Batterhead221/brain_board/docs/ADC.png

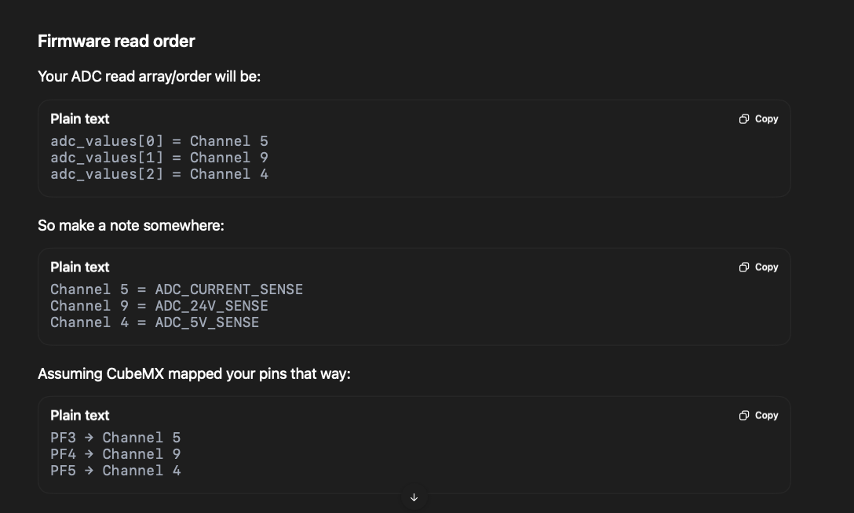
docs/ADC.png
