Batterhead221/brain_board/docs/STM32H753ZITx_LQFP144.png

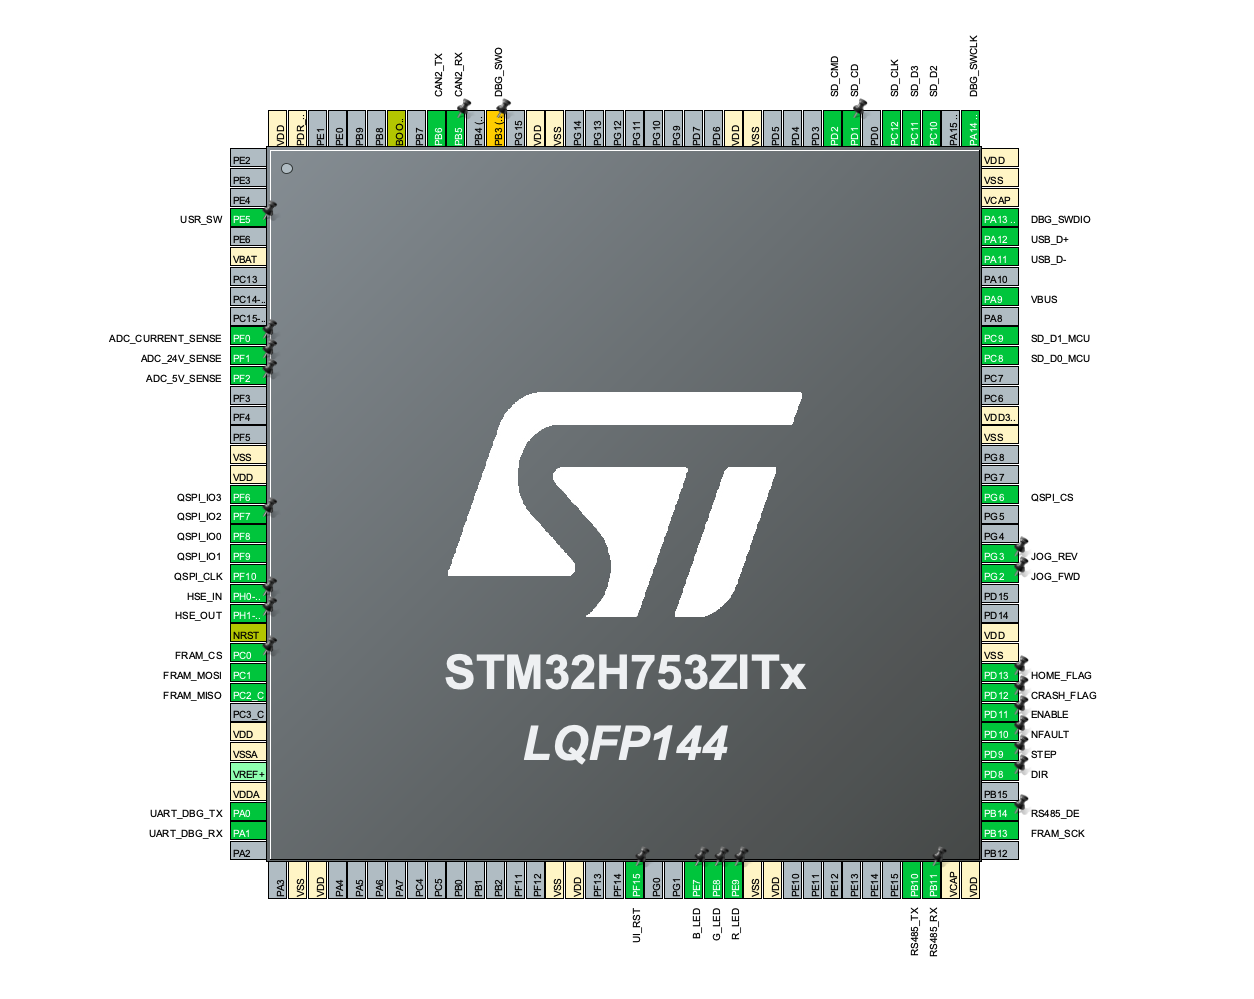
docs/STM32H753ZITx_LQFP144.png
