Batterhead221/brain_board/Outputs/IMG/L1-SIG.png

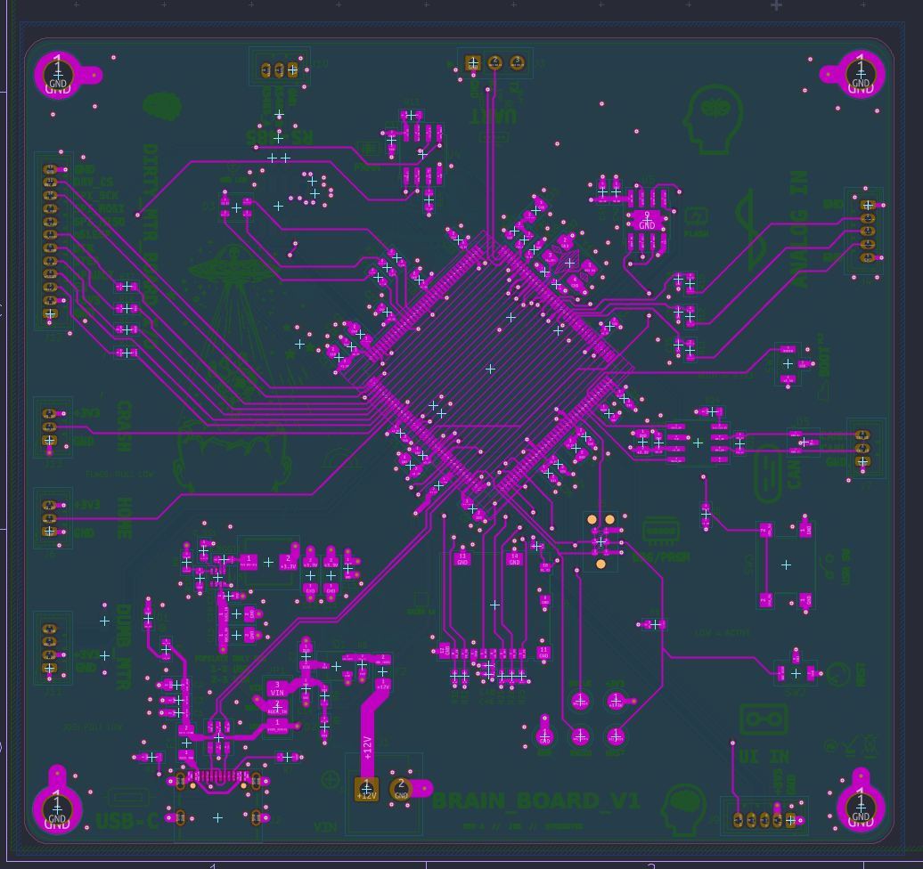
Outputs/IMG/L1-SIG.png
