Batterhead221/brain_board/Outputs/IMG/L2-3V3.png

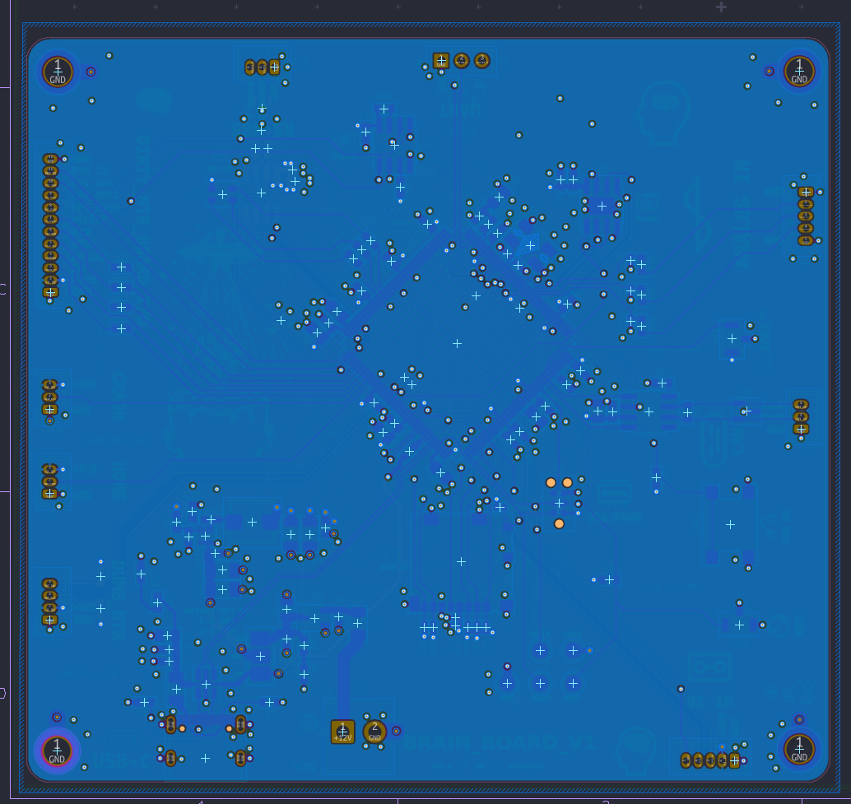
Outputs/IMG/L2-3V3.png
