Batterhead221/brain_board/Outputs/IMG/L3-GND.png

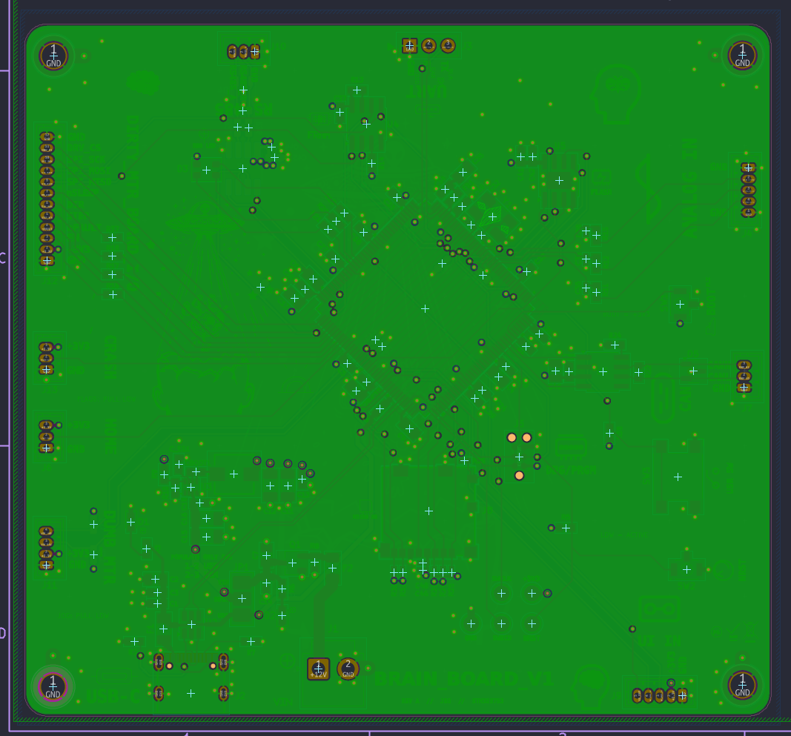
Outputs/IMG/L3-GND.png
