Batterhead221/brain_board/Outputs/IMG/L4-MIX.png

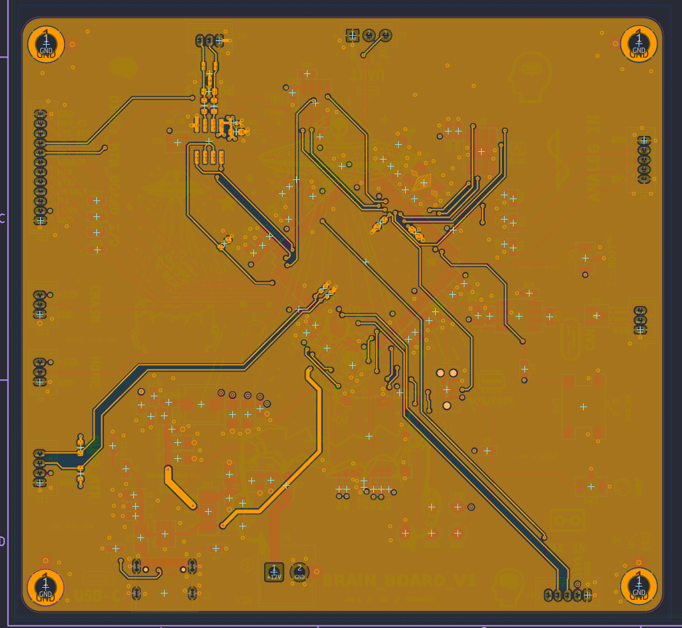
Outputs/IMG/L4-MIX.png
