Batterhead221/brain_board/Outputs/IMG/SCHEMATIC.png

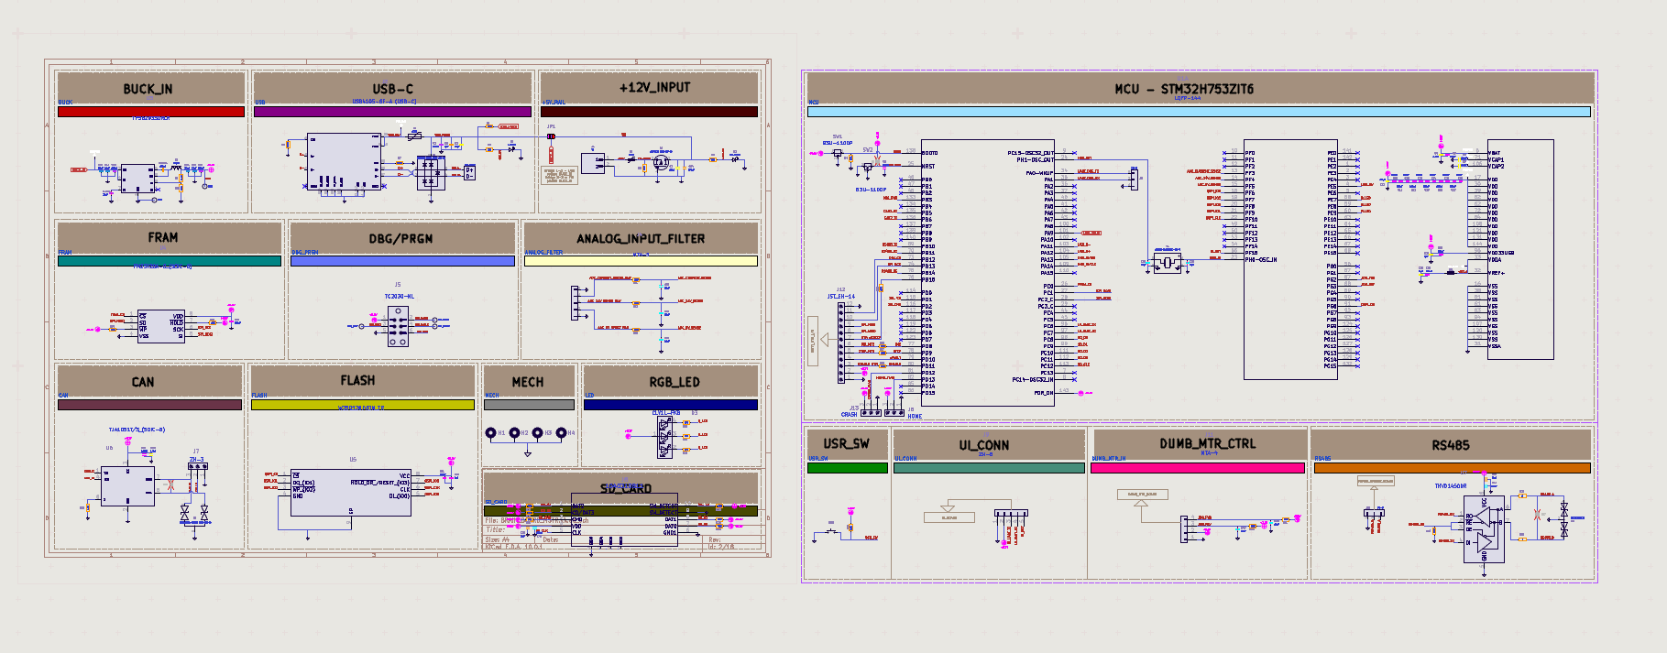
Outputs/IMG/SCHEMATIC.png
