Batterhead221/brain_board/docs/Brain_Board_Connector_Notes.ods

Sheet: Connector Summary
BRAIN_BOARD CONNECTOR REFERENCE
BRAIN_BOARD_V1 / REV A – PINOUT
REF | NAME / PURPOSE | INTERFACE TYPE | PIN COUNT | CONNECTOR TYPE | KEY NOTES
J1 | V-IN INPUT | EXTERNAL POWER INPUT | 2 | JST-VH | EXTERNAL DC INPUT. USE JP1 TO SELECT VIN PATH
J2 | USB-C | USB DATA / OPTIONAL USB POWER PATH | - | USB-C | USB_OTG_FS DEVICE MODE; PA11 D-, PA12 D+, PA9 VBUS
J3 | DEBUG UART | 3-PIN SERIAL DEBUG HEADER | 3 | DUPONT | UART4 ON PA0/PA1
J4 | ANALOG INPUT | ADC INPUT HEADER | 5 | JST-EH | ADC3 SENSE INPUTS ON PF3/PF4/PF5
J5 | DBG/PRGM | SWD PROGRAMMING/DEBUG | 6 | TAG-CONNECT | VTREF, SWDIO, GND, SWCLK, NRST, SWO
J6 | DUMB_MTR_IN | MANUAL JOG / MOTOR-CONTROL INPUT BOARD | 4 | JST-EH | ACTIVE-LOW JOG_FWD/JOG_REV; EXTERNAL BUTTONS PULL TO GND
J7 | CAN | CAN BUS CONNECTOR | 3 | JST-EH | CANH/CANL/GND VIA CAN TRANSCEIVER. 120 OHM ONLY AT BUS END
J8 | MICRO-SD | MICROSD CARD SOCKET | - | - | SDMMC1 4-BIT BUS; CMD AND D0-D3 NEED PULL-UPS
J9 | UI_IN | UI/DISPLAY DAUGHTER-BOARD CONNECTOR | 5 | JST-EH | USART6 ON PC6/PC7 PLUS UI_RST ON PF15
J10 | RS485 | RS485 BUS CONNECTOR | 3 | JST-EH | USART3 ON PB10/PB11; PB14 RS485_DE
J11 | HOME | HOME SWITCH / FLAG INPUT | 3 | JST-EH | ACTIVE-LOW HOME_FLAG ON PD13
J12 | DIRTY_MTR_BOARD I/O | MOTOR-DRIVER DAUGHTER-BOARD CONTROL | 12 | JST-EH | LOGIC/CONTROL ONLY; NO VM MOTOR POWER
J13 | CRASH | CRASH/LIMIT SWITCH INPUT | 3 | JST-EH | ACTIVE-LOW CRASH_FLAG ON PD12
JP1 | POWER SOURCE SELECT | USB/VIN SELECTION JUMPER | 3 | JUMPER | POPULATE ONLY ONE SOURCE SELECTION: 1-2 USB, 2-3 VIN

Sheet: Pinouts
Brain_Board Connector Pinout Table
All connector pins/signals in one filterable table
Connector | Connector Name | Pin | Signal | Direction | MCU Pin / Peripheral | Voltage / Level | Notes | Verify?
J1 | VIN Input | 1 | GND | Power | Board ground | 0 V | Board ground reference
J1 | VIN Input | 2 | VIN | Power input | Power path | External VIN | External DC input; use JP1 to select VIN path
J2 | USB-C | - | USB_D+ | Bidirectional | PA12 / USB_OTG_FS_DP | USB differential | USB device D+ line; ESD close to connector
J2 | USB-C | - | USB_D- | Bidirectional | PA11 / USB_OTG_FS_DM | USB differential | USB device D- line; ESD close to connector
J2 | USB-C | - | USB_VBUS | Input / power path | PA9 / VBUS sense | 5 V USB | Used for USB VBUS sensing and/or USB power path
J2 | USB-C | - | CC1/CC2 | Configuration | USB-C CC network | USB-C | Attach/orientation configuration; verify CC resistors
J2 | USB-C | - | GND | Power | Board ground | 0 V | USB ground
J3 | Debug UART | 1 | GND | Power ref | GND | 0 V | Connect to USB-UART adapter GND
J3 | Debug UART | 2 | UART_DBG_RX / MCU_RX | Input to MCU | PA1 / UART4_RX | 3.3 V logic | Connect to adapter TX
J3 | Debug UART | 3 | UART_DBG_TX / MCU_TX | Output from MCU | PA0 / UART4_TX | 3.3 V logic | Connect to adapter RX
J4 | Analog Input | 1 | GND | Power ref | GND | 0 V | Analog/reference ground | Verify final pin order
J4 | Analog Input | 2 | ADC_CURRENT_SENSE | Input | PF3 / ADC3 Channel 5 | 0-3.3 V max | Current-sense input; Rank 1 | Verify final pin order
J4 | Analog Input | 3 | ADC_24V_SENSE | Input | PF4 / ADC3 Channel 9 | 0-3.3 V max | Scaled 24 V sense input; Rank 2 | Verify final pin order
J4 | Analog Input | 4 | ADC_5V_SENSE | Input | PF5 / ADC3 Channel 4 | 0-3.3 V max | Scaled 5 V sense input; Rank 3 | Verify final pin order
J4 | Analog Input | 5 | Reserved / Analog spare | Input | TBD | 0-3.3 V max | Verify against final KiCad schematic | Yes
J4 | Analog Input | 6 | GND | Power ref | GND | 0 V | Analog/reference ground | Verify final pin order
J5 | DBG/PRGM SWD | 1 | VTREF_3V3 | Reference | 3V3 rail | 3.3 V | Target voltage reference for debugger, not main power input | Verify final pin order
J5 | DBG/PRGM SWD | 2 | SWDIO | Bidirectional | PA13 / SWDIO | 3.3 V logic | SWD data | Verify final pin order
J5 | DBG/PRGM SWD | 3 | GND | Power ref | GND | 0 V | Debug ground | Verify final pin order
J5 | DBG/PRGM SWD | 4 | SWCLK | Input | PA14 / SWCLK | 3.3 V logic | SWD clock | Verify final pin order
J5 | DBG/PRGM SWD | 5 | NRST | Bidirectional | NRST | 3.3 V logic | Target reset | Verify final pin order
J5 | DBG/PRGM SWD | 6 | SWO | Output | PB3 / SWO | 3.3 V logic | Optional trace/debug output | Verify final pin order
J6 | DUMB_MTR_IN | 1 | +3V3 | Power output | 3V3 rail | 3.3 V | Optional logic supply for external button board | Verify final pin order
J6 | DUMB_MTR_IN | 2 | JOG_FWD | Input | PG2 / GPIO input pull-up | Active-low | Button open = HIGH; pressed = LOW | Verify final pin order
J6 | DUMB_MTR_IN | 3 | JOG_REV | Input | PG3 / GPIO input pull-up | Active-low | Button open = HIGH; pressed = LOW | Verify final pin order
J6 | DUMB_MTR_IN | 4 | GND | Power ref | GND | 0 V | External switch/button ground | Verify final pin order
J7 | CAN | 1 | CANH | Bidirectional | CAN transceiver bus side | CAN bus | CAN high line | Verify final pin order
J7 | CAN | 2 | CANL | Bidirectional | CAN transceiver bus side | CAN bus | CAN low line | Verify final pin order
J7 | CAN | 3 | GND | Power ref | GND | 0 V | Bus reference ground | Verify final pin order
J8 | microSD Socket | - | SD_D0 | Bidirectional | PC8 / SDMMC1_D0 | 3.3 V logic | SDMMC1 data 0
J8 | microSD Socket | - | SD_D1 | Bidirectional | PC9 / SDMMC1_D1 | 3.3 V logic | SDMMC1 data 1
J8 | microSD Socket | - | SD_D2 | Bidirectional | PC10 / SDMMC1_D2 | 3.3 V logic | SDMMC1 data 2
J8 | microSD Socket | - | SD_D3 | Bidirectional | PC11 / SDMMC1_D3 | 3.3 V logic | SDMMC1 data 3
J8 | microSD Socket | - | SD_CLK | Output | PC12 / SDMMC1_CK | 3.3 V logic | SDMMC clock
J8 | microSD Socket | - | SD_CMD | Bidirectional | PD2 / SDMMC1_CMD | 3.3 V logic | SD command
J8 | microSD Socket | - | SD_CD | Input | PD1 / GPIO input pull-up | Active-low typical | Card detect; verify socket behavior
J8 | microSD Socket | - | +3V3 | Power | 3V3 rail | 3.3 V | microSD supply
J8 | microSD Socket | - | GND | Power | GND | 0 V | microSD ground
J9 | UI_IN | 1 | +3V3 | Power output | 3V3 rail | 3.3 V | UI logic supply | Verify final pin order
J9 | UI_IN | 2 | UI_UART_TX | Output from MCU | PC6 / USART6_TX | 3.3 V logic | MCU transmit to UI board | Verify final pin order
J9 | UI_IN | 3 | UI_UART_RX | Input to MCU | PC7 / USART6_RX | 3.3 V logic | MCU receive from UI board | Verify final pin order
J9 | UI_IN | 4 | UI_RST | Output | PF15 / GPIO output | 3.3 V logic | LOW = UI held in reset; HIGH = release | Verify final pin order
J9 | UI_IN | 5 | GND | Power ref | GND | 0 V | Ground | Verify final pin order
J10 | RS485 | 1 | RS485_A / RS485_P | Bidirectional | RS485 transceiver bus side | RS485 differential | Positive/non-inverting bus line; verify naming | Verify final pin order
J10 | RS485 | 2 | RS485_B / RS485_N | Bidirectional | RS485 transceiver bus side | RS485 differential | Negative/inverting bus line; verify naming | Verify final pin order
J10 | RS485 | 3 | GND | Power ref | GND | 0 V | Bus reference ground | Verify final pin order
J11 | HOME | 1 | +3V3 | Power output | 3V3 rail | 3.3 V | Optional powered sensor/flag supply | Verify final pin order
J11 | HOME | 2 | HOME_FLAG | Input | PD13 / EXTI pull-up | Active-low | Open = HIGH; tripped = LOW | Verify final pin order
J11 | HOME | 3 | GND | Power ref | GND | 0 V | Switch/sensor ground | Verify final pin order
J12 | DIRTY_MTR_BOARD I/O | 1 | GND | Power ref | GND | 0 V | Common ground | Verify against Dirty_MTR board
J12 | DIRTY_MTR_BOARD I/O | 2 | +3V3 | Power output | 3V3 rail | 3.3 V | Logic reference/supply only | Verify against Dirty_MTR board
J12 | DIRTY_MTR_BOARD I/O | 3 | EN / ENABLE | Output | PD11 / GPIO output | 3.3 V logic | Default LOW; driver disabled at boot | Verify against Dirty_MTR board
J12 | DIRTY_MTR_BOARD I/O | 4 | nSLEEP / MTR_nSLEEP | Output | PB15 / GPIO output | Active-low | Default LOW; driver asleep at boot | Verify against Dirty_MTR board
J12 | DIRTY_MTR_BOARD I/O | 5 | nFAULT / MTR_nFAULT | Input | PD10 / GPIO input pull-up | Active-low | LOW = driver fault | Verify against Dirty_MTR board
J12 | DIRTY_MTR_BOARD I/O | 6 | STEP | Output | PD9 / GPIO output | 3.3 V logic | Step pulse output; default LOW | Verify against Dirty_MTR board
J12 | DIRTY_MTR_BOARD I/O | 7 | DIR | Output | PD8 / GPIO output | 3.3 V logic | Direction output; default LOW | Verify against Dirty_MTR board
J12 | DIRTY_MTR_BOARD I/O | 8 | DRV_CS | Output | PB12 / GPIO output | 3.3 V logic | SPI chip-select; default HIGH | Verify against Dirty_MTR board
J12 | DIRTY_MTR_BOARD I/O | 9 | SPI_SCK | Output | PB13 / SPI2_SCK | 3.3 V logic | Shared SPI clock | Verify against Dirty_MTR board
J12 | DIRTY_MTR_BOARD I/O | 10 | SPI_MOSI | Output | PC1 / SPI2_MOSI | 3.3 V logic | MCU to driver | Verify against Dirty_MTR board
J12 | DIRTY_MTR_BOARD I/O | 11 | SPI_MISO | Input | PC2_C / SPI2_MISO | 3.3 V logic | Driver to MCU | Verify against Dirty_MTR board
J12 | DIRTY_MTR_BOARD I/O | 12 | GND | Power ref | GND | 0 V | Common ground | Verify against Dirty_MTR board
J13 | CRASH | 1 | +3V3 | Power output | 3V3 rail | 3.3 V | Optional powered sensor/flag supply | Verify final pin order
J13 | CRASH | 2 | CRASH_FLAG | Input | PD12 / EXTI pull-up | Active-low | Open = HIGH; tripped = LOW | Verify final pin order
J13 | CRASH | 3 | GND | Power ref | GND | 0 V | Switch/sensor ground | Verify final pin order
JP1 | Power Source Select | 1-2 | USB source selected | Power jumper | USB power path | USB 5 V path | Populate only one source selection | Verify final schematic
JP1 | Power Source Select | 2-3 | VIN source selected | Power jumper | VIN power path | VIN path | Populate only one source selection | Verify final schematic

Sheet: MCU Signal Map
MCU Signal Map
Firmware-facing map of signals, pins, and connector usage
Signal | MCU Pin | Peripheral / Mode | Connector(s) | Direction | Boot / Default | Notes
UART_DBG_TX | PA0 | UART4_TX | J3 | Output | 115200 8N1 | Debug boot log TX
UART_DBG_RX | PA1 | UART4_RX | J3 | Input | 115200 8N1 | Debug console RX
USB_D- | PA11 | USB_OTG_FS_DM | J2 | Bidirectional | USB Device | USB D-
USB_D+ | PA12 | USB_OTG_FS_DP | J2 | Bidirectional | USB Device | USB D+
VBUS | PA9 | USB VBUS sense | J2 | Input | VBUS sensing | USB attach/power sense
SWDIO | PA13 | SWDIO | J5 | Bidirectional | Debug | SWD data
SWCLK | PA14 | SWCLK | J5 | Input | Debug | SWD clock
SWO | PB3 | SWO | J5 | Output | Optional | Trace/debug output
CAN2_RX | PB5 | FDCAN2_RX | J7 | Input | 500 kbit/s Classic CAN | From CAN transceiver
CAN2_TX | PB6 | FDCAN2_TX | J7 | Output | 500 kbit/s Classic CAN | To CAN transceiver
RS485_TX | PB10 | USART3_TX | J10 | Output | 115200 8N1 | To RS485 transceiver DI
RS485_RX | PB11 | USART3_RX | J10 | Input | 115200 8N1 | From RS485 transceiver RO
RS485_DE | PB14 | GPIO Output | J10 | Output | LOW | LOW=receive/listen, HIGH=transmit
DRV_CS | PB12 | GPIO Output | J12 | Output | HIGH | SPI device deselected
SPI_SCK | PB13 | SPI2_SCK | J12 / FRAM | Output | 8-bit SPI, slow prescaler | Shared SPI clock
MTR_nSLEEP | PB15 | GPIO Output | J12 | Output | LOW | Driver asleep at boot
FRAM_CS | PC0 | GPIO Output | FRAM | Output | HIGH | FRAM deselected
SPI_MOSI | PC1 | SPI2_MOSI | J12 / FRAM | Output | 8-bit SPI | MCU to SPI devices
SPI_MISO | PC2_C | SPI2_MISO | J12 / FRAM | Input | 8-bit SPI | SPI devices to MCU
UI_UART_TX | PC6 | USART6_TX | J9 | Output | 115200 8N1 | UI daughter-board UART TX
UI_UART_RX | PC7 | USART6_RX | J9 | Input | 115200 8N1 | UI daughter-board UART RX
SD_D0 | PC8 | SDMMC1_D0 | J8 | Bidirectional | 4-bit SD bus | microSD data 0
SD_D1 | PC9 | SDMMC1_D1 | J8 | Bidirectional | 4-bit SD bus | microSD data 1
SD_D2 | PC10 | SDMMC1_D2 | J8 | Bidirectional | 4-bit SD bus | microSD data 2
SD_D3 | PC11 | SDMMC1_D3 | J8 | Bidirectional | 4-bit SD bus | microSD data 3
SD_CLK | PC12 | SDMMC1_CK | J8 | Output | Very high speed | microSD clock
SD_CMD | PD2 | SDMMC1_CMD | J8 | Bidirectional | 4-bit SD bus | microSD command
SD_CD | PD1 | GPIO Input pull-up | J8 | Input | Pull-up | Card detect
DIR | PD8 | GPIO Output | J12 | Output | LOW | Motor direction
STEP | PD9 | GPIO Output | J12 | Output | LOW | Motor step pulse
MTR_nFAULT | PD10 | GPIO Input pull-up | J12 | Input | HIGH normal | LOW=fault
ENABLE | PD11 | GPIO Output | J12 | Output | LOW | Motor driver disabled at boot
CRASH_FLAG | PD12 | EXTI Input pull-up | J13 | Input | HIGH normal | LOW=crash/limit active
HOME_FLAG | PD13 | EXTI Input pull-up | J11 | Input | HIGH normal | LOW=home active
USR_SW | PE5 | GPIO Input pull-up | SW3 | Input | HIGH normal | LOW=pressed
B_LED | PE7 | GPIO Output | LED | Output | LOW | Blue LED control
G_LED | PE8 | GPIO Output | LED | Output | LOW | Green heartbeat LED
R_LED | PE9 | GPIO Output | LED | Output | LOW | Red LED control
ADC_CURRENT_SENSE | PF3 | ADC3 Channel 5 | J4 | Input | Rank 1 | 0-3.3 V max
ADC_24V_SENSE | PF4 | ADC3 Channel 9 | J4 | Input | Rank 2 | 0-3.3 V max
ADC_5V_SENSE | PF5 | ADC3 Channel 4 | J4 | Input | Rank 3 | 0-3.3 V max
QSPI_IO3 | PF6 | QUADSPI IO3 | Flash | Bidirectional | QSPI | External flash IO3
QSPI_IO2 | PF7 | QUADSPI IO2 | Flash | Bidirectional | QSPI | External flash IO2
QSPI_IO0 | PF8 | QUADSPI IO0 | Flash | Bidirectional | QSPI | External flash IO0
QSPI_IO1 | PF9 | QUADSPI IO1 | Flash | Bidirectional | QSPI | External flash IO1
QSPI_CLK | PF10 | QUADSPI CLK | Flash | Output | QSPI | External flash clock
UI_RST | PF15 | GPIO Output | J9 | Output | LOW | LOW=UI held reset
JOG_FWD | PG2 | GPIO Input pull-up | J6 | Input | HIGH normal | LOW=jog forward pressed
JOG_REV | PG3 | GPIO Input pull-up | J6 | Input | HIGH normal | LOW=jog reverse pressed
QSPI_CS | PG6 | GPIO / QSPI CS | Flash | Output | TBD | External flash chip select
HSE_IN | PH0 | RCC HSE_IN | Y1 | Input | 25 MHz HSE | Crystal input
HSE_OUT | PH1 | RCC HSE_OUT | Y1 | Output | 25 MHz HSE | Crystal output

Sheet: Active-Low Signals
Active-Low / Boot-Safe Signals
Signals that need special attention during firmware bring-up
Signal | Connector / Location | MCU Pin | Active State | Inactive State | Pull / Default | Firmware Note
MTR_nSLEEP | J12 | PB15 | LOW = sleep | HIGH = awake | Output LOW at boot | Do not wake driver until motor board is tested
MTR_nFAULT | J12 | PD10 | LOW = fault | HIGH = normal | Input pull-up | Poll or later use EXTI/fault handling
HOME_FLAG | J11 | PD13 | LOW = active | HIGH = inactive | EXTI input pull-up | Mechanical switch pulls to GND
CRASH_FLAG | J13 | PD12 | LOW = active | HIGH = inactive | EXTI input pull-up | Treat as safety-critical
JOG_FWD | J6 | PG2 | LOW = pressed | HIGH = open | Input pull-up | External button pulls to GND
JOG_REV | J6 | PG3 | LOW = pressed | HIGH = open | Input pull-up | External button pulls to GND
USR_SW | SW3 | PE5 | LOW = pressed | HIGH = open | Input pull-up | On-board user switch
RS485_DE | J10 / transceiver | PB14 | HIGH = transmit | LOW = receive | Output LOW at boot | Not active-low, but keep LOW at boot for listen mode

Sheet: Bring-Up Checklist
Brain_Board Bring-Up Checklist
Recommended first-test order after boards arrive
Order | Stage | Check / Action | Expected Result | Connector / Area | Done
1 | Power-off inspection | Inspect PCB for solder bridges, wrong footprints, and backwards polarized parts | No visible shorts or orientation errors | Full board
2 | Resistance checks | Measure +3V3 to GND, VIN to GND, USB_VBUS to GND | No dead short | Power rails
3 | Power source select | Verify JP1 source selection | Only one source path selected | JP1
4 | First power | Power from current-limited supply if possible | Current draw sane, no hot parts | J1/J2/JP1
5 | Rail check | Measure +3V3 rail | 3.3 V nominal | 3V3 test point / rail
6 | Reset/boot | Verify NRST high and BOOT0 low | Normal boot state | J5 / SW1
7 | SWD attach | Connect ST-Link to DBG/PRGM | Debugger detects STM32H753 | J5
8 | Flash firmware | Flash heartbeat firmware | Programming succeeds | J5
9 | LED heartbeat | Observe G_LED blink | Blink every ~500 ms | G_LED
10 | Debug UART | Connect USB-UART and read boot message | Brain_Board boot | J3
11 | Safe motor state | Check MTR_nSLEEP, ENABLE, STEP, DIR, DRV_CS | nSLEEP LOW, ENABLE LOW, STEP LOW, DIR LOW, CS HIGH | J12
12 | ADC readback | Read ADC3 channels | Reasonable scaled values | J4
13 | SPI FRAM | Test FRAM over SPI2 | JEDEC/read-write test passes if supported | FRAM / SPI2
14 | microSD | Test card detect and SDMMC mount | Card detect works, filesystem mounts | J8
15 | USB device | Plug USB-C to host | USB enumerates | J2
16 | RS485 | Test TX/RX with DE control | Receive mode default, transmit works when DE high | J10
17 | CAN | Test CAN with second node or analyzer | 500 kbit/s Classic CAN frames pass | J7
18 | Daughter board link | Connect Dirty_MTR_Board with motor power OFF first | Logic/control signals match pinout | J12
19 | Motor test last | Enable motor driver and step slowly | Motor moves only after all logic tests pass | Dirty_MTR_Board
