Batterhead221/brain_board/ECAD/BRAIN_BOARD.kicad_pcb

## KiCad design ECAD/BRAIN_BOARD.kicad_pcb (2026-05-13)

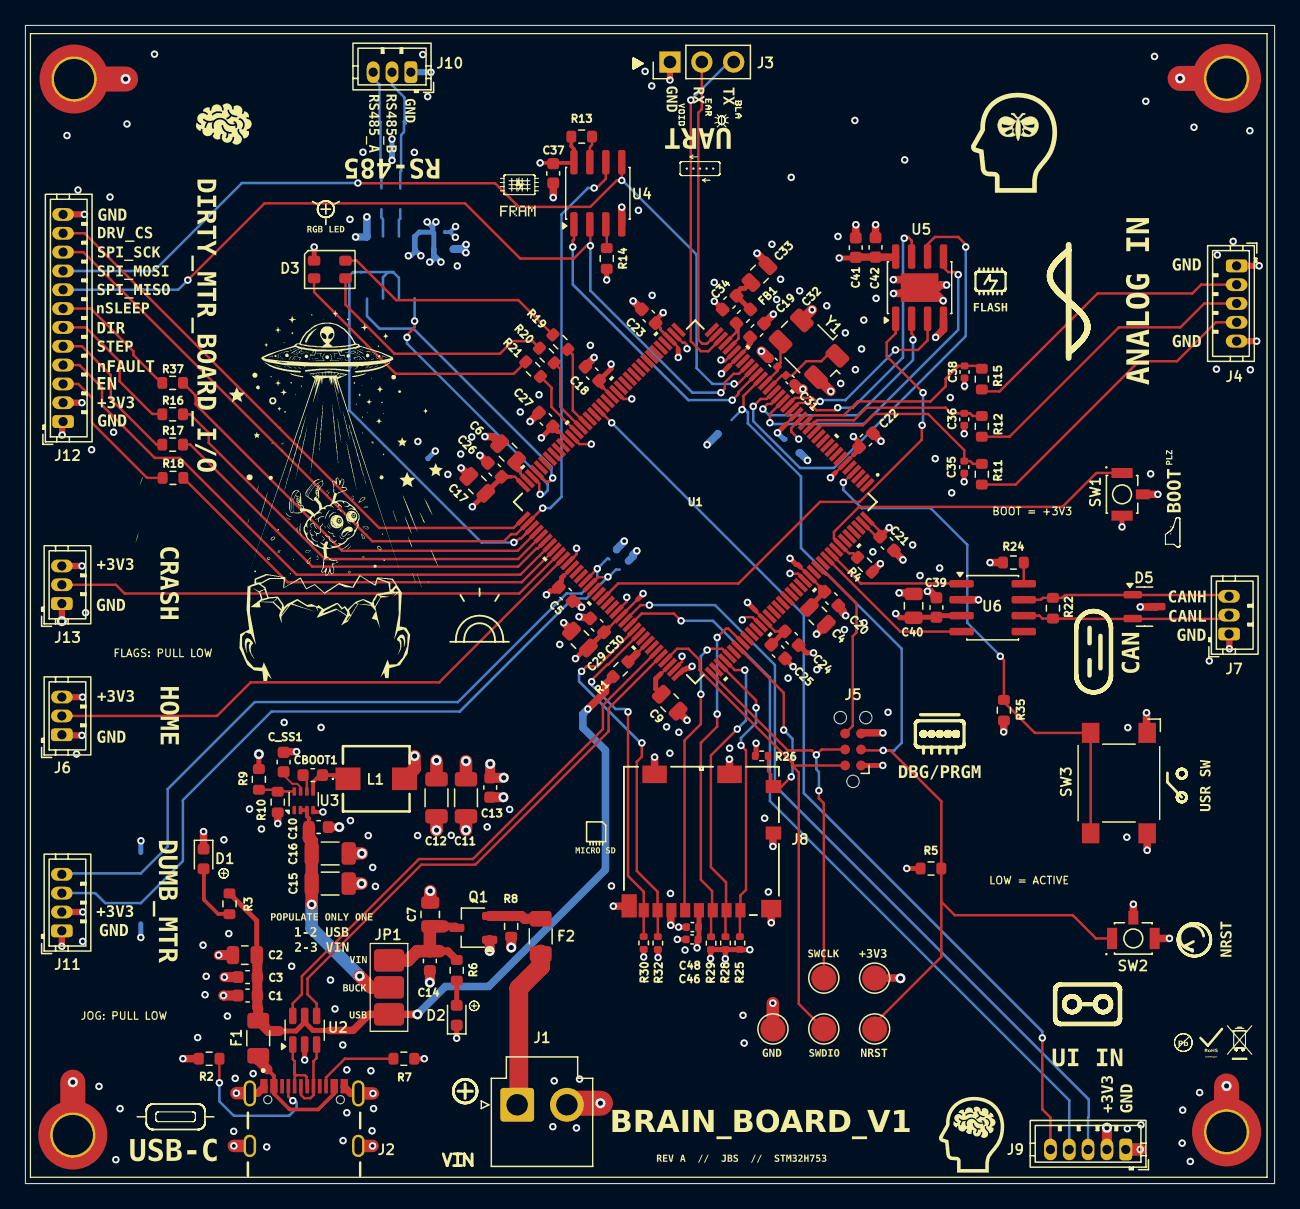
[picture p10: board BRAIN_BOARD.kicad_pcb from above]

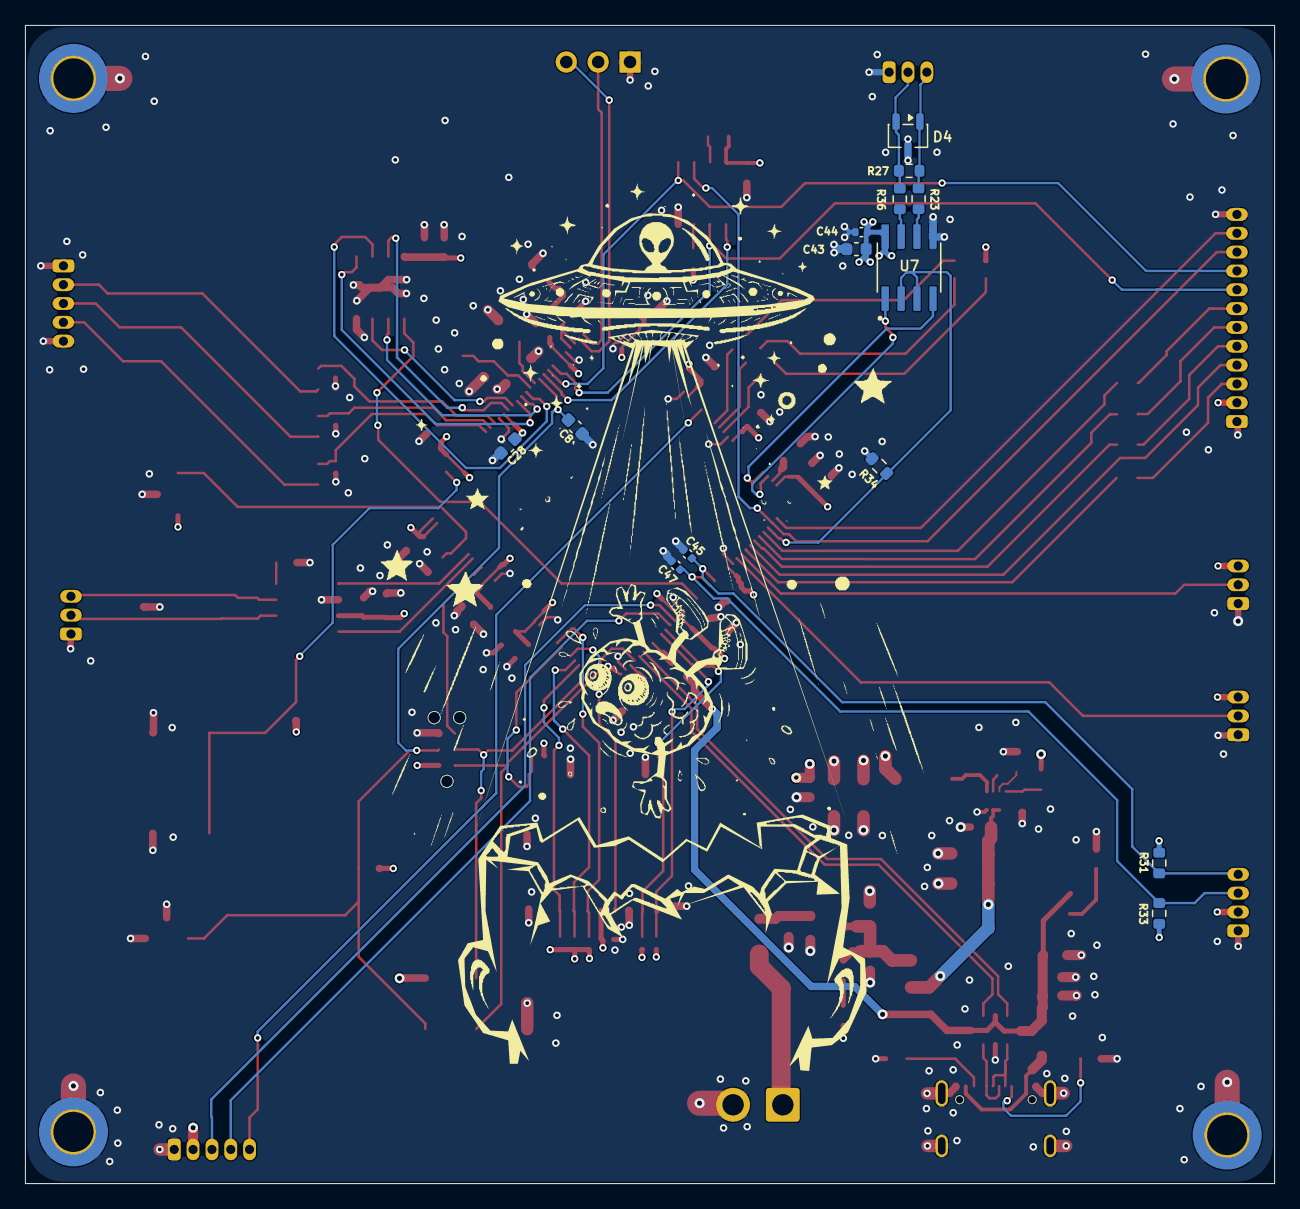
[picture p11: board BRAIN_BOARD.kicad_pcb from below]

Board: 4 copper layers, 99.5 x 92.2 mm, 131 parts (14 on the bottom side), 95 nets.

Parts:
C1, C5, C8, C10, C13, C14, C18, C19, C20, C21, C22, C23, C24, C25, C26, C27, C28, C30, C34, C37, C41: 100nF; C_0603_1608Metric
C2, C7: 10µF; C_0805_2012Metric
C3, C42: 1µF; C_0603_1608Metric
C4, C6, C9: 2.2µF; C_0805_2012Metric
C11, C12: 22µF; C_1206_3216Metric
C15, C16: 10µF; C_1206_3216Metric
C17, C40: 4.7µF; C_0805_2012Metric
C29, C33: 1µF; C_0805_2012Metric
C31, C32: 18pF; C_0402_1005Metric
C35, C36, C38, C45, C47: 10nF; C_0402_1005Metric
C39: 100NF; C_0603_1608Metric
C43: 10µF; C_0603_1608Metric
C44, C46: 100nF; C_0402_1005Metric
C48: 1µF; C_0402_1005Metric
CBOOT1: 100nF; C_0603_1608Metric
C_SS1: 33nF; C_0603_1608Metric
D1: +5V_SIG; LED_0603_1608Metric
D2: LED_GREEN; LED_0603_1608Metric
D3: CLV1L-FKB; LED_Cree-PLCC4_3.2x2.8mm_CCW
D4: SM712_SOT23; SOT-23-3
D5: SM24CANB-02HTG (SOT-23-3); SOT-23
F1, F2: 1206; Fuse_1206_3216Metric
FB1: FERRITE_BEAD; Fuse_0603_1608Metric
H1, H2, H3, H4: MountingHole_Pad; MountingHole_3.2mm_M3_ISO14580_Pad_TopBottom
J1: VH; JST_VH_B2P-VH_1x02_P3.96mm_Vertical
J2: USB4105-GF-A (USB-C); GCT_USB4105-GF-A
J3: ZH-3; PinHeader_1x03_P2.54mm_Vertical
J4: MTA-5; JST_ZH_B5B-ZR_1x05_P1.50mm_Vertical
J5: TC2030-NL; Tag-Connect_TC2030-IDC-NL_2x03_P1.27mm_Vertical
J6: HOME; JST_ZH_B3B-ZR_1x03_P1.50mm_Vertical
J7: ZH-3; JST_ZH_B3B-ZR_1x03_P1.50mm_Vertical
J8: 1040310811; 104031-0811_MOL
J9: ZH-5; JST_ZH_B5B-ZR_1x05_P1.50mm_Vertical
J10: PH-3; JST_ZH_B3B-ZR_1x03_P1.50mm_Vertical
J11: MTA-4; JST_ZH_B4B-ZR_1x04_P1.50mm_Vertical
J12: JST_EH-14; JST_ZH_B12B-ZR_1x12_P1.50mm_Vertical
J13: CRASH; JST_ZH_B3B-ZR_1x03_P1.50mm_Vertical
JP1: BEEFY_JUMPER; PWR_JMP_BEEFY
L1: 4.7µH; L_SRP5030TA4R7M
Q1: AO3407A (SOT-23-3); TSOT-23
R1, R5, R8, R10, R13, R14, R31, R33, R34, R35: 10K; R_0603
R2, R7: 5.1K; R_0603
R3, R6: 750; R_0603
R4: 5K1; R_0603
R9: 31.6K; R_0603
R11, R12, R15, R16, R17, R18, R37: 100; R_0603
R19, R20, R21: 470; R_0603
R22, R27: 120; R_0603
R23, R36: 0; R_0603
R24: 4.7K; R_0603
R25, R28, R29, R30, R32: 47K; R_0402_1005Metric
R26: 10K; R_0402_1005Metric
SW1, SW2: B3U-1100P; SW_B3U-1100P
SW3: SW_SPST_Omron_B3FS-100xP
TP1: 3.3V; TestPoint_Pad_D2.0mm
TP2: GND; TestPoint_Pad_D2.0mm
TP3: DBG_SWDIO; TestPoint_Pad_D2.0mm
TP4: DBG_NRST; TestPoint_Pad_D2.0mm
TP5: DBG_SWCLK; TestPoint_Pad_D2.0mm
U1: LQFP-144; LQFP144-20x20mm
U2: USBLC6-2SC6_(SOT-23-6); SOT-23-6
U3: TPS62933DRLR; SOT-583-8
U4: FM25V20A-G_(SOIC-8); SOIC-8_3.9x4.9mm_P1.27mm
U5: W25Q128JVEIM_TR; SOIC-8-1EP_3.9x4.9mm_P1.27mm_EP2.29x3mm
U6: TJA1051T/3_(SOIC-8); SOIC-8_3.9x4.9mm_P1.27mm
U7: THVD1450DR; SOIC127P599X175-8N
Y1: ABM3B-8.000MHZ-B2-T; Crystal_SMD_Abracon_ABM3B-4Pin_5.0x3.2mm

Connections:
+3.3V: C4.1, C5.1, C11.2, C12.2, C13.1, C17.1, C18.1, C19.1, C20.1, C21.1, C22.1, C23.1, C24.1, C25.1, C26.1, C27.1, C28.1, C29.2, C30.2, C37.2, C39.2, C40.2, C41.2, C42.2, C43.1, C44.2, C46.1, C48.2, D3.1 (A), J5.1 (+3V3), J6.3, J8.4 (VDD), J9.2, J11.2, J12.2, J13.3, L1.2, R5.1, R9.2, R13.1, R14.2, R25.2, R26.1, R28.2, R29.2, R30.1, R31.1, R32.1, R33.1, R35.2, SW1.2, TP1.1, U1.6 (VBAT), U1.17 (VDD), U1.30 (VDD), U1.39 (VDD), U1.52 (VDD), U1.62 (VDD), U1.72 (VDD), U1.84 (VDD), U1.95 (VDD33USB), U1.108 (VDD), U1.121 (VDD), U1.131 (VDD), U1.143 (PDR_ON), U1.144 (VDD), U4.8 (VDD), U5.8 (VCC), U6.3 (VCC), U7.8 (VCC)
/BRAIN_BOARD/+3V3_A: FB1.2, U1.32 (VREF+), U1.33 (VDDA)
/BRAIN_BOARD/+5V_SIG: D1.2 (A), R3.2
/BRAIN_BOARD/+12V: F2.1, J1.1
/BRAIN_BOARD/+12V_SIG: D2.2 (A), R6.2
/BRAIN_BOARD/ADC_5V_SENSE: C38.1, R15.1, U1.15 (PF5)
/BRAIN_BOARD/ADC_5V_SENSE_RAW: J4.2, R15.2
/BRAIN_BOARD/ADC_24V_SENSE: C36.1, R12.1, U1.14 (PF4)
/BRAIN_BOARD/ADC_24V_SENSE_RAW: J4.3, R12.2
/BRAIN_BOARD/ADC_CURRENT_SENSE: C35.1, R11.1, U1.13 (PF3)
/BRAIN_BOARD/ADC_CURRENT_SENSE_RAW: J4.4, R11.2
/BRAIN_BOARD/BOOT0: R4.1, SW1.1, U1.138 (BOOT0)
/BRAIN_BOARD/B_LED: R19.1, U1.58 (PE7)
/BRAIN_BOARD/CAN2_RX: U1.135 (PB5), U6.4 (RXD)
/BRAIN_BOARD/CAN2_TX: U1.136 (PB6), U6.1 (TXD)
/BRAIN_BOARD/CAN_HI: D5.1 (PIN_1), J7.3, R22.1, U6.7 (CANH)
/BRAIN_BOARD/CAN_LO: D5.2 (PIN_2), J7.2, R22.2, U6.6 (CANL)
/BRAIN_BOARD/CRASH_FLAG: J13.2, U1.81 (PD12)
/BRAIN_BOARD/D+: J2.A6 (D+), J2.B6 (D+), U2.3 (L2)
/BRAIN_BOARD/D-: J2.A7 (D-), J2.B7 (D-), U2.1 (L1)
/BRAIN_BOARD/DBG_NRST: C8.2, J5.3 (NRST), R5.2, SW2.1, TP4.1, U1.25 (NRST)
/BRAIN_BOARD/DBG_SWCLK: J5.4 (SWCLK), TP5.1, U1.109 (PA14)
/BRAIN_BOARD/DBG_SWDIO: J5.2 (SWDIO), TP3.1, U1.105 (PA13)
/BRAIN_BOARD/DBG_SWO: J5.6 (SWO), U1.133 (PB3)
/BRAIN_BOARD/DIR: R16.1, U1.77 (PD8)
/BRAIN_BOARD/DIR_MTR: J12.6, R16.2
/BRAIN_BOARD/DRV_CS: J12.11, U1.73 (PB12)
/BRAIN_BOARD/ENABLE: R18.1, U1.80 (PD11)
/BRAIN_BOARD/ENABLE_MTR: J12.3, R18.2
/BRAIN_BOARD/FRAM_CS: U1.26 (PC0), U4.1 (~CS)
/BRAIN_BOARD/G_LED: R20.1, U1.59 (PE8)
/BRAIN_BOARD/HOME_FLAG: J6.2, U1.82 (PD13)
/BRAIN_BOARD/HSE_IN: C31.1, U1.23 (PH0-OSC_IN), Y1.1
/BRAIN_BOARD/HSE_OUT: C32.2, U1.24 (PH1-OSC_OUT), Y1.3
/BRAIN_BOARD/JOG_FWD: C45.1, J11.4, R31.2, U1.87 (PG2)
/BRAIN_BOARD/JOG_REV: C47.1, J11.3, R33.2, U1.88 (PG3)
/BRAIN_BOARD/MTR_nSLEEP: J12.7, R37.2
/BRAIN_BOARD/QSPI_CLK: U1.22 (PF10), U5.6 (CLK)
/BRAIN_BOARD/QSPI_CS: U1.91 (PG6), U5.1 (~CS)
/BRAIN_BOARD/QSPI_IO0: U1.20 (PF8), U5.5 (DI_(IO0))
/BRAIN_BOARD/QSPI_IO1: U1.21 (PF9), U5.2 (DO_(IO1))
/BRAIN_BOARD/QSPI_IO2: U1.19 (PF7), U5.3 (~WP_(IO2))
/BRAIN_BOARD/QSPI_IO3: U1.18 (PF6), U5.7 (~HOLD_OR_/RESET_(IO3))
/BRAIN_BOARD/RS485_A: D4.1 (A1), J10.3, R23.2, R27.1
/BRAIN_BOARD/RS485_B: D4.2 (A2), J10.2, R27.2, R36.2
/BRAIN_BOARD/RS485_DE: R34.1, U1.75 (PB14), U7.2 (~RE), U7.3 (DE)
/BRAIN_BOARD/RS485_RX: U1.70 (PB11), U7.1 (RO)
/BRAIN_BOARD/RS485_TX: U1.69 (PB10), U7.4 (DI)
/BRAIN_BOARD/R_LED: R21.1, U1.60 (PE9)
/BRAIN_BOARD/SD_ CD: J8.10 (SW_DETECT), R26.2, U1.115 (PD1)
/BRAIN_BOARD/SD_CLK: J8.5 (CLK), U1.113 (PC12)
/BRAIN_BOARD/SD_CMD: J8.3 (CMD), R29.1, U1.116 (PD2)
/BRAIN_BOARD/SD_D0: J8.7 (DAT0), R32.2, U1.98 (PC8)
/BRAIN_BOARD/SD_D1: J8.8 (DAT1), R30.2, U1.99 (PC9)
/BRAIN_BOARD/SD_D2: J8.1 (DAT2), R25.1, U1.111 (PC10)
/BRAIN_BOARD/SD_D3: J8.2 (CD/DAT3), R28.1, U1.112 (PC11)
/BRAIN_BOARD/SPI_MISO: J12.8, U1.28 (PC2_C), U4.2 (SO)
/BRAIN_BOARD/SPI_MOSI: J12.9, U1.27 (PC1), U4.5 (SI)
/BRAIN_BOARD/SPI_SCK: J12.10, U1.74 (PB13), U4.6 (SCK)
/BRAIN_BOARD/STEP: R17.1, U1.78 (PD9)
/BRAIN_BOARD/STEP_MTR: J12.5, R17.2
/BRAIN_BOARD/UART_DBG_RX: J3.2, U1.35 (PA1)
/BRAIN_BOARD/UART_DBG_TX: J3.3, U1.34 (PA0-WKUP)
/BRAIN_BOARD/UI_RST: J9.5, U1.55 (PF15)
/BRAIN_BOARD/UI_UART_RX: J9.4, U1.97 (PC7)
/BRAIN_BOARD/UI_UART_TX: J9.3, U1.96 (PC6)
/BRAIN_BOARD/USB_D+: U1.104 (PA12), U2.4 (L2)
/BRAIN_BOARD/USB_D-: U1.103 (PA11), U2.6 (L1)
/BRAIN_BOARD/USR_SW: R35.1, SW3.2, U1.4 (PE5)
/BRAIN_BOARD/VBUS_FUSED: C1.1, C2.2, C3.2, F1.2, JP1.1 (A), R1.2, R3.1, U2.5 (VP)
/BRAIN_BOARD/VBUS_RAW: F1.1, J2.A4_B9 (VBUS), J2.B4_A9 (VBUS)
/BRAIN_BOARD/VIN: C7.2, C14.2, JP1.3 (B), Q1.3 (D), R6.1
/BRAIN_BOARD/VIN_FUSED: F2.2, Q1.2 (S), R8.2
/BRAIN_BOARD/nFAULT: J12.4, U1.79 (PD10)
BUCK_IN: C10.1, C15.1, C16.1, JP1.2 (C), U3.2 (EN), U3.3 (VIN)
GND: C1.2, C2.1, C3.1, C4.2, C5.2, C6.2, C7.1, C8.1, C9.2, C10.2, C11.1, C12.1, C13.2, C14.1, C15.2, C16.2, C17.2, C18.2, C19.2, C20.2, C21.2, C22.2, C23.2, C24.2, C25.2, C26.2, C27.2, C28.2, C29.1, C30.1, C31.2, C32.1, C33.1, C34.1, C35.2, C36.2, C37.1, C38.2, C39.1, C40.1, C41.1, C42.1, C43.2, C44.1, C45.2, C46.2, C47.2, C48.1, C_SS1.1, D1.1 (K), D2.1 (K), D4.3 (common), D5.3 (PIN_3), H1.1 (1_1), H2.1 (1_1), H3.1 (1_1), H4.1 (1_1), J1.2, J2.A1_B12 (GND), J2.B1_A12 (GND), J2.SH1 (SH_GND), J2.SH2 (SH_GND1), J2.SH3 (SH_GND2), J2.SH4 (SH_GND3), J3.1, J4.1, J4.5, J5.5 (GND), J6.1, J7.1, J8.6 (GND1), J8.9 (SW_DETECT), J8.11 (GND5), J8.12 (GND4), J8.13 (GND3), J8.14 (GND2), J9.1, J10.1, J11.1, J12.1, J12.12, J13.1, Q1.1 (G), R2.1, R4.2, R7.2, R8.1, R10.1, R24.2, R34.2, SW1.3, SW2.2, SW2.3, SW3.1, TP2.1, U1.16 (VSS), U1.31 (VSSA), U1.38 (VSS), U1.51 (VSS), U1.61 (VSS), U1.83 (VSS), U1.94 (VSS), U1.107 (VSS), U1.120 (VSS), U1.130 (VSS), U2.2 (VN), U3.4 (GND), U4.4 (VSS), U5.4 (GND), U5.9 (EP), U6.2 (GND), U7.5 (GND), Y1.2, Y1.4
unnamed: C33.2, C34.2, FB1.1
unnamed: D3.4 (BK), R19.2
unnamed: D3.3 (GK), R20.2
unnamed: D3.2 (RK), R21.2
unnamed: J2.A5 (CC1), R2.2
unnamed: J2.B5 (CC2), R7.1
unnamed: R37.1, U1.76 (PB15)
unnamed: C6.1, U1.71 (VCAP1)
unnamed: C9.1, U1.106 (VCAP2)
unnamed: CBOOT1.1, U3.6 (BST)
unnamed: R9.1, R10.2, U3.8 (FB)
unnamed: C_SS1.2, U3.7 (SS)
unnamed: CBOOT1.2, L1.1, U3.5 (SW)
unnamed: R13.2, U4.7 (~HOLD)
unnamed: R14.1, U4.3 (~WP)
unnamed: R24.1, U6.8 (S)
unnamed: R23.1, U7.6 (A)
unnamed: R36.1, U7.7 (B)
USB_VBUS: R1.1, U1.101 (PA9)
