Batterhead221/brain_board/firmware/STM32H753ZIT6/STM32H753ZIT6.ioc

Mcu.UserName=STM32H753ZITx
PA0.Signal=UART4_TX
PA1.Signal=UART4_RX
PA11.GPIO_Label=USB_D-
PA11.Signal=USB_OTG_FS_DM
PA12.GPIO_Label=USB_D+
PA12.Signal=USB_OTG_FS_DP
PA9.GPIO_Label=VBUS
PA9.Signal=USB_OTG_FS_VBUS
PB10.GPIO_Label=USART3_TX (485)
PB10.Signal=USART3_TX
PB11.GPIO_Label=USART3_RX (485)
PB11.Signal=USART3_RX
PB12.GPIO_Label=DRV_CS
PB12.Signal=GPIO_Output
PB14.GPIO_Label=RS485_DE
PB14.Signal=GPIO_Output
PB15.GPIO_Label=MTR_nSLEEP
PB15.Signal=GPIO_Output
PB5.GPIO_Label=CAN2_RX
PB5.Signal=FDCAN2_RX
PB6.GPIO_Label=CAN2_TX
PB6.Signal=FDCAN2_TX
PC0.GPIO_Label=FRAM_CS
PC0.Signal=GPIO_Output
PC1.GPIO_Label=FRAM_MOSI
PC1.Signal=SPI2_MOSI
PC10.GPIO_Label=SD_D2
PC10.Signal=SDMMC1_D2
PC11.GPIO_Label=SD_D3
PC11.Signal=SDMMC1_D3
PC12.GPIO_Label=SD_CLK
PC12.Signal=SDMMC1_CK
PC2_C.GPIO_Label=FRAM_MISO
PC2_C.Signal=SPI2_MISO
PC6.GPIO_Label=USART6_TX (UI)
PC6.Signal=USART6_TX
PC7.GPIO_Label=USART6_RX (UI)
PC7.Signal=USART6_RX
PC8.GPIO_Label=SD_D0_MCU
PC8.Signal=SDMMC1_D0
PC9.GPIO_Label=SD_D1_MCU
PC9.Signal=SDMMC1_D1
PD1.GPIO_Label=SD_CD
PD1.Signal=GPIO_Input
PD10.GPIO_Label=nFAULT
PD10.Signal=GPIO_Input
PD11.GPIO_Label=ENABLE
PD11.Signal=GPIO_Output
PD12.GPIO_Label=CRASH_FLAG
PD12.Signal=GPXTI12
PD13.GPIO_Label=HOME_FLAG
PD13.Signal=GPXTI13
PD2.GPIO_Label=SD_CMD
PD2.Signal=SDMMC1_CMD
PD3.GPIO_Label=SPI_SCK
PD3.Signal=SPI2_SCK
PD8.GPIO_Label=DIR
PD8.Signal=GPIO_Output
PD9.GPIO_Label=STEP
PD9.Signal=GPIO_Output
PE5.GPIO_Label=USR_SW
PE5.Signal=GPIO_Input
PE7.GPIO_Label=B_LED
PE7.Signal=GPIO_Output
PE8.GPIO_Label=G_LED
PE8.Signal=GPIO_Output
PE9.GPIO_Label=R_LED
PE9.Signal=GPIO_Output
PF10.GPIO_Label=QSPI_CLK
PF10.Signal=QUADSPI_CLK
PF15.GPIO_Label=UI_RST
PF15.Signal=GPIO_Output
PF3.GPIO_Label=ADC_CURRENT_SENSE
PF3.Signal=ADC3_INP5
PF4.GPIO_Label=ADC_24V_SENSE
PF4.Signal=ADC3_INP9
PF5.GPIO_Label=ADC_5V_SENSE
PF5.Signal=ADC3_INP4
PF6.GPIO_Label=QSPI_IO3
PF6.Signal=QUADSPI_BK1_IO3
PF7.GPIO_Label=QSPI_IO2
PF7.Signal=QUADSPI_BK1_IO2
PF8.GPIO_Label=QSPI_IO0
PF8.Signal=QUADSPI_BK1_IO0
PF9.GPIO_Label=QSPI_IO1
PF9.Signal=QUADSPI_BK1_IO1
PG2.GPIO_Label=JOG_FWD
PG2.Signal=GPIO_Input
PG3.GPIO_Label=JOG_REV
PG3.Signal=GPIO_Input
PG6.GPIO_Label=QSPI_CS
PG6.Signal=QUADSPI_BK1_NCS
