Batterhead221/brain_board/(commit log)

2026-05-03 Add initial STM32 firmware project and gitignore
    [BRAIN_BOARD.kicad_pcb, BRAIN_BOARD.kicad_sch]
2026-05-06 removed EH connectors
    [BRAIN_BOARD.kicad_pcb, Brain_Board_Connector_Notes.ods]
2026-05-13 Revised repo
    [BRAIN_BOARD.kicad_pcb, BRAIN_BOARD.kicad_sch]
2026-05-13 Added stitching vias
    [BRAIN_BOARD.kicad_pcb]
