Batterhead221/brain_board/(notices)

Notices in the files:
firmware/STM32H753ZIT6/Core/Src/main.c:
Copyright (c) 2026 STMicroelectronics.
All rights reserved.
This software is licensed under terms that can be found in the LICENSE file
